mck1117/atlas/models/SelectablePullup.asc

M1: pmos; FDC638P
M2: pmos; FDC638P
M3: nmos; AP9465GEM
R1: res; 10k
R2: res; 2.7k
V1: voltage; 5
V2: voltage; 2.5
V3: voltage; 4
Named nets: 0
.dc v2 -20 20
