mck1117/atlas/models/HighPowerReverseProtection.asc

D1: zener; BZX84C6V2L
M1: pmos; HAT1072H
M2: nmos; AP9465GEM
M3: pmos; HAT1072H
R1: res; 1k
R2: res; 1
R3: res; 10k
V1: voltage; 1
V2: voltage; 5
Named nets: 0, vin, vout, vg, vs
.dc v1 -36 36
