mck1117/atlas/models/RegulatorInputFilter.asc

C1: cap; 56µ; Rser=35m
C2: cap; 56µ; Rser=35m
C3: cap; 1µ; Rser=1m
C4: cap; 4.7µ
I1: current; ""; AC 1
L1: ind; 2.2µ; Rser=1
R1: res; 1
V1: voltage; 14
Named nets: 0
.ac dec 500 100 1e8
