mck1117/atlas/models/RegulatorEnPin.asc

D1: zener; 1N750
I1: current; 5µ
R1: res; 47k
R2: res; 47k
V1: voltage; 1
Named nets: 0
.dc V1 -10 24
