mck1117/atlas/atlas/IgnInj4.kicad_sch

## KiCad design atlas/IgnInj4.kicad_sch (2022-06-28, an earlier design)

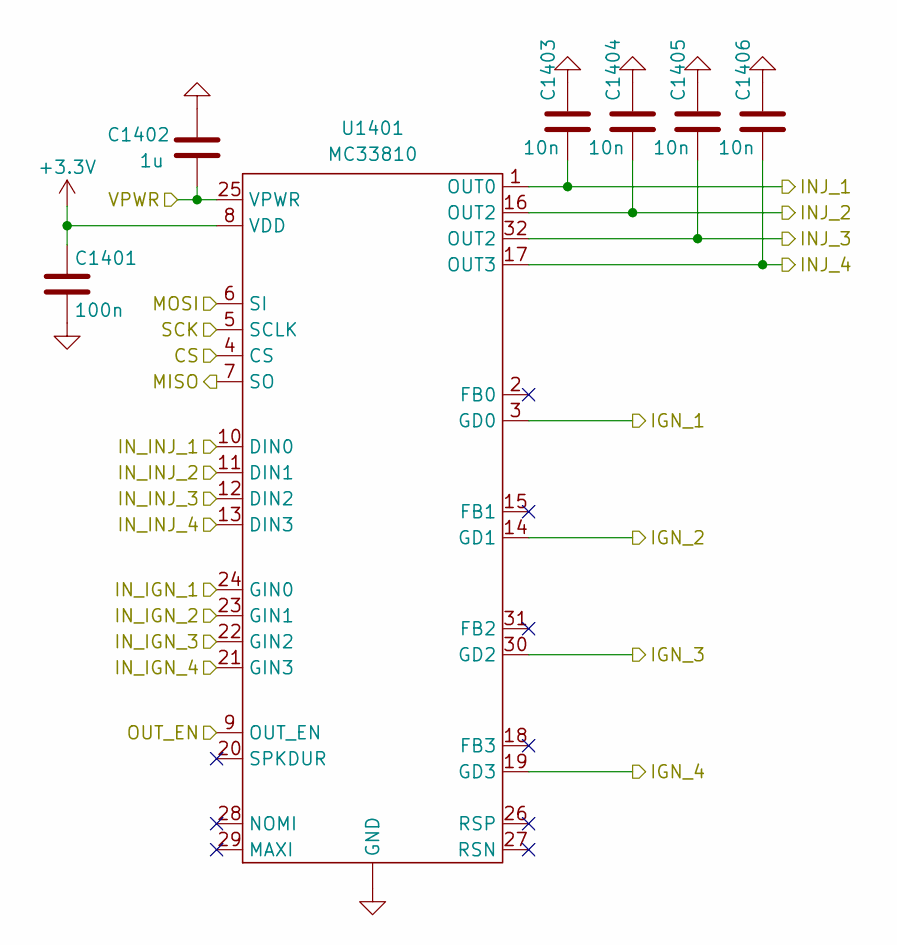
[picture p1: schematic IgnInj4.kicad_sch]

Parts:
C1401: 100n; C_0402_1005Metric
C1402: 1u; C_0603_1608Metric; LCSC C15849
C1403, C1404, C1405, C1406: 10n; C_0603_1608Metric; LCSC C57112
U1401: MC33810; SOIC-8-1EP_3.9x4.9mm_P1.27mm_EP2.29x3mm

Connections:
+3.3V: C1401.1, U1401.8 (VDD)
CS: U1401.4 (CS)
GND: C1401.2, C1402.2, C1403.1, C1404.1, C1405.1, C1406.1, U1401. (GND)
IGN_1: U1401.3 (GD0)
IGN_2: U1401.14 (GD1)
IGN_3: U1401.30 (GD2)
IGN_4: U1401.19 (GD3)
INJ_1: C1403.2, U1401.1 (OUT0)
INJ_2: C1404.2, U1401.16 (OUT2)
INJ_3: C1405.2, U1401.32 (OUT2)
INJ_4: C1406.2, U1401.17 (OUT3)
IN_IGN_1: U1401.24 (GIN0)
IN_IGN_2: U1401.23 (GIN1)
IN_IGN_3: U1401.22 (GIN2)
IN_IGN_4: U1401.21 (GIN3)
IN_INJ_1: U1401.10 (DIN0)
IN_INJ_2: U1401.11 (DIN1)
IN_INJ_3: U1401.12 (DIN2)
IN_INJ_4: U1401.13 (DIN3)
MISO: U1401.7 (SO)
MOSI: U1401.6 (SI)
OUT_EN: U1401.9 (OUT_EN)
SCK: U1401.5 (SCLK)
VPWR: C1402.1, U1401.25 (VPWR)
