mck1117/atlas/atlas/can.kicad_sch

## KiCad design atlas/can.kicad_sch (2022-06-28, an earlier design)

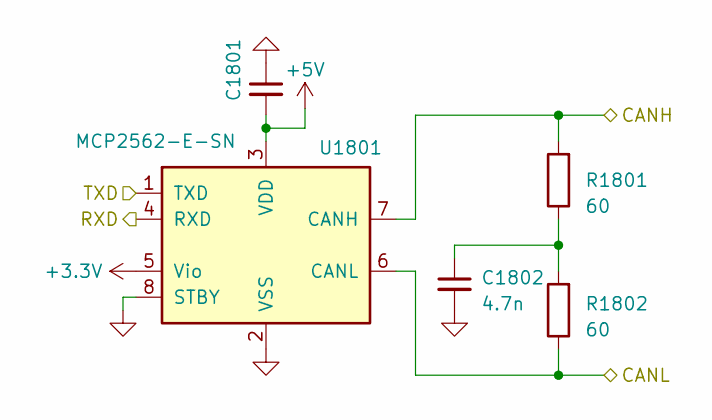
[picture p2: schematic can.kicad_sch]

Parts:
C1801: 100n; C_0402_1005Metric; LCSC C1525
C1802: 4.7n; C_0603_1608Metric
R1801, R1802: 60; R_0805_2012Metric
U1801: MCP2562-E-SN; SOIC-8_3.9x4.9mm_P1.27mm

Connections:
+3.3V: U1801.5 (Vio)
+5V: C1801.2, U1801.3 (VDD)
CANH: R1801.2, U1801.7 (CANH)
CANL: R1802.1, U1801.6 (CANL)
GND: C1801.1, C1802.2, U1801.2 (VSS), U1801.8 (STBY)
unnamed: C1802.1, R1801.1, R1802.2
RXD: U1801.4 (RXD)
TXD: U1801.1 (TXD)
