mck1117/atlas/atlas/quad_analog.kicad_sch

## KiCad design atlas/quad_analog.kicad_sch (2022-06-28, an earlier design)

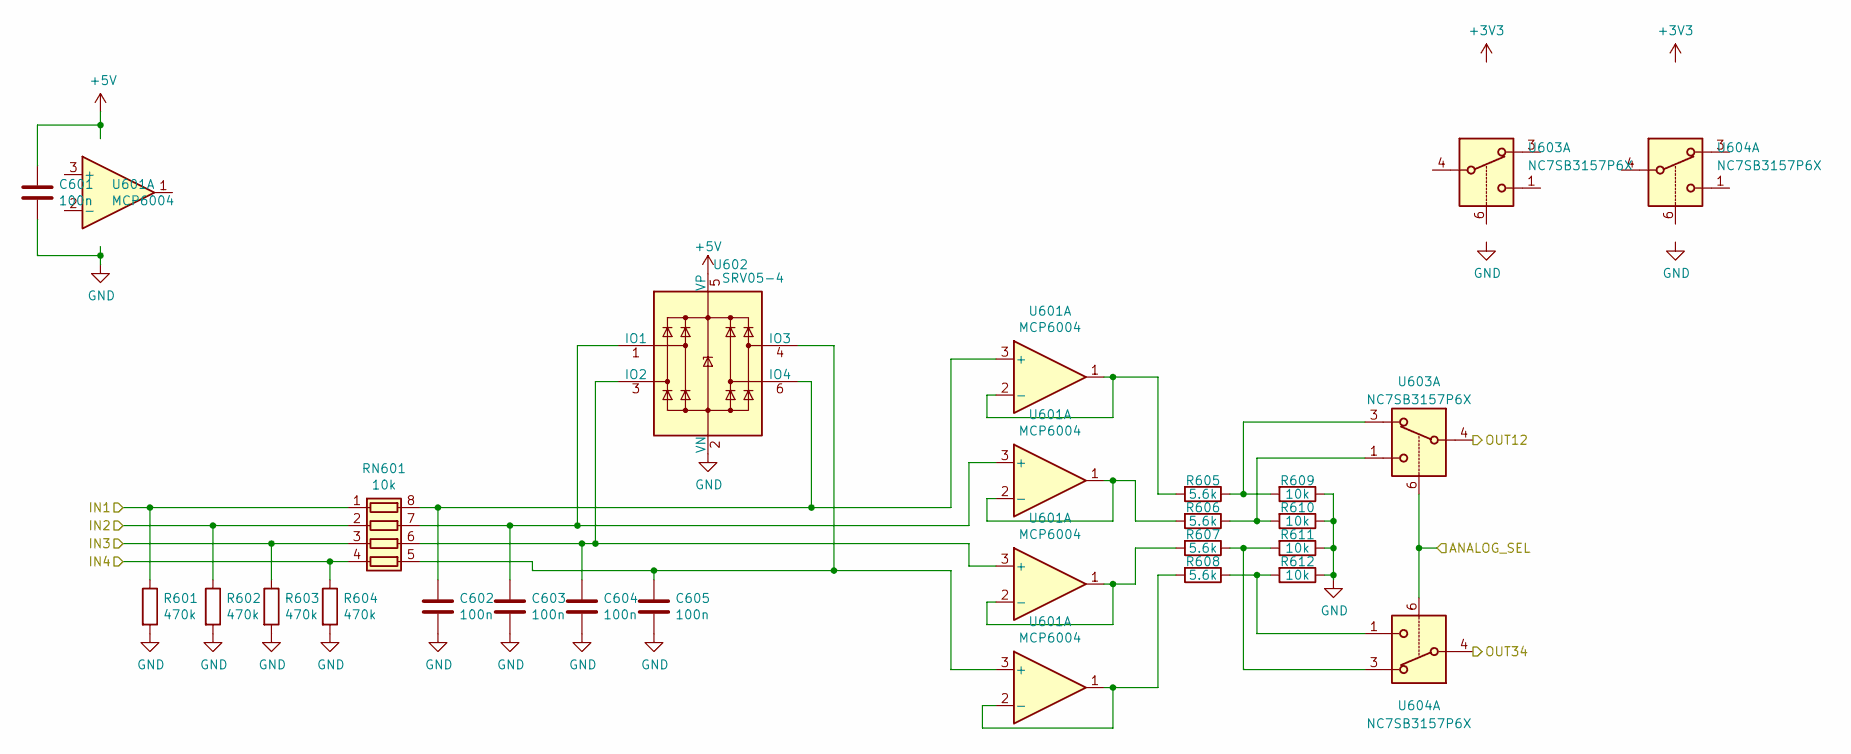
[picture p3: schematic quad_analog.kicad_sch]

Parts:
C601: 100n; C_0603_1608Metric; LCSC C14663
C602, C603, C604, C605: 100n; C_0402_1005Metric; LCSC C1525
R601, R602, R603, R604: 470k; R_0402_1005Metric; LCSC C25790
R605, R606, R607, R608: 5.6k; R_0402_1005Metric; LCSC C25908
R609, R610, R611, R612: 10k; R_0402_1005Metric; LCSC C25744
RN601: 10k; R_Array_Convex_4x0603; LCSC C29718
U601: MCP6004; TSSOP-14_4.4x5mm_P0.65mm; LCSC C7975
U602: SRV05-4; SOT-23-6; LCSC C85364
U603, U604: NC7SB3157P6X; SOT-363_SC-70-6; LCSC C87403

Connections:
+5V: C601.1, U602.5 (VP)
ANALOG_SEL: U603.6, U604.6
GND: C601.2, C602.2, C603.2, C604.2, C605.2, R601.2, R602.2, R603.2, R604.2, R609.1, R610.1, R611.1, R612.1, U602.2 (VN)
IN1: R601.1, RN601.1 (R1.1)
IN2: R602.1, RN601.2 (R2.1)
IN3: R603.1, RN601.3 (R3.1)
IN4: R604.1, RN601.4 (R4.1)
unnamed: C602.1, RN601.8 (R1.2), U601.3 (+), U602.6 (IO4)
unnamed: C603.1, RN601.7 (R2.2), U601.3 (+), U602.1 (IO1)
unnamed: C604.1, RN601.6 (R3.2), U601.3 (+), U602.3 (IO2)
unnamed: C605.1, RN601.5 (R4.2), U601.3 (+), U602.4 (IO3)
unnamed: R605.1, R609.2, U603.3
unnamed: R605.2, U601.1, U601.2 (-)
unnamed: R606.1, R610.2, U603.1
unnamed: R606.2, U601.1, U601.2 (-)
unnamed: R607.1, R611.2, U604.3
unnamed: R607.2, U601.1, U601.2 (-)
unnamed: R608.1, R612.2, U604.1
unnamed: R608.2, U601.1, U601.2 (-)
OUT12: U603.4
OUT34: U604.4
