mck1117/atlas/(threads)

Thread 10 (2021-07-18):

standby supply + battery

mck1117, 2021-07-18:
- regulator for VBAT to supply rtc and backup RAM on vehicles with constant 12v
- coin cell holder for vehicles without constant 12v

kjngineering, 2021-07-19:
Does it make sense to use a pcb mounted LIR2430 with a recharge diode from the standby rail? that way even if the battery is removed backup tables, RTC etc can be stored for some time.

mck1117, 2021-07-20:
standby regulator selected is TPS70933DBV

Thread 11 (2021-07-18):

power supply - 12v supply

mck1117, 2021-07-18:
- two pins, one for 12v raw and one for 12v ign
- diode OR together so either can power the regulator input
- 12v ign pin sets enable on regulator

mck1117, 2021-07-19:
like this:

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

mck1117, 2021-07-20:
The two resistors connected to the EN pin have changed to both 47k, this simulation says it should work ok:

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

Thread 5 (2021-07-18):

aux lowside outputs

mck1117, 2021-07-18:
How many to include?

Probably VNLD5090 or similar (or maybe single channel similar VN series chips)

kjngineering, 2021-07-19:
What are things that use aux low side:

PWM Cooling Fans
PWM A/C Compressor
PWM Water Pump
PWM/Digital Cam Phasers
PWM Oil control valve
PWM Fuel Pump (2-step, returnless)

Thread 6 (2021-07-18):

analog voltage inputs

mck1117, 2021-07-18:
12-16 channels

mck1117, 2021-07-18:
"maximum" input usage might be
- ETB TPS x4
- Pedal x2
- MAP
- compressor outlet pressure
- throttle inlet pressure
- OilP
- FuelP (x2)
- analog lambda x2

that totals ~14, so minimum viable is probably 16

kjngineering, 2021-07-19:
My experience is with motorsport but additional analog channels that I have used with regularity:

-Gearbox Compressor Pressure
-Gearbox Oil Pressure
-Gearbox Position Sensor (1x Main, 1x Tracking)
-Fuel Level
-Ambient Pressure/BAP
-Airbox Pressure
-P/Steer Pressure

Basically you can never have too many AV channels. But I also think that a CAN AV - I/O expander is also a smart idea.

kjngineering, 2021-07-19:
also consider @Dron_gus' experience using MC33972 as an analog mux for "low priority" AV polling (e.g. probably cannot exceed 10hz? with a reasonable measurement window for each sensor) - temperatures? internal diagnostic channels?

mck1117, 2021-07-19:
Another cheap option is to slap a bunch of N-to-1 analog muxes on, all switched together, so you can select one of N "banks" of analog that all get sampled in sequence.  We have plenty of time left over for more analog sampling, and it happens over DMA so the CPU load is essentially zero.

```
select_bank(0);
sample_all_adc_channels();
select_bank(1);
sample_all_adc_channels();
```

Thread 7 (2021-07-18):

analog temperature inputs

mck1117, 2021-07-18:
4-8 inputs with pullup

kjngineering, 2021-07-19:
Would it be better to leave these as AV inputs and can "switch" them to AT with a programmable pullup. Maximizes AV inputs for those who need.

Thread 8 (2021-07-18):

Onboard WBO lambda

mck1117, 2021-07-18:
2x internal wideband modules

kjngineering, 2021-07-19:
I really prefer external wideband modules that can be mounted in the engine bay and aren't tying up ecu connector IO, it also means that you can choose how many UGEO sensors required for the application.

Thread 12 (2021-07-19):

power supply - 5v & 3.3v

mck1117, 2021-07-19:
5v buck regulator
3.3v linear

TODO: which power domains should receive power from USB? Only the 3.3v domain?

Thread 13 (2021-07-19):

sensor supply

mck1117, 2021-07-19:
TLS115 seems ok, why change?

kjngineering, 2021-07-19:
Sensor supplies should have internal voltage measurement for diagnostics, can tell if a sensor is shorting the rail to ground.

ideally 3x 5v0 Sensor supplies.

mck1117, 2021-07-19:
The TLS115 at least has a "power good" output that indicates whether it's out of spec by ~70mV typical

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

kjngineering, 2021-07-19:
Some diagnostics is better than none.

mck1117, 2021-07-19:
And the PG pin is actually wired on Proteus already (but no sw for it), so we could test that with existing hardware.

Thread 14 (2021-07-19):

digital inputs

mck1117, 2021-07-19:
8? 12? digital inputs, ~2-4k pullup to 5v

kjngineering, 2021-07-19:
I really like the idea of the programmable threshold of the Universal DIG on MoTeC, what is the feasibility of this?

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

mck1117, 2021-07-19:
Programmable threshold (especially such a wide range) and hysteresis is haaaaard to do. Not cheap either.

Best I can guess, it'd need:
- DAC per channel
- digipot per channel to set hysteresis
- comparator to compare dac threshold against input signal

Not to mention an inverting boost converter to generate +-10v rails even during low voltage input (cranking, low battery and broken alternator, etc), and at least one opamp per channel to expand the range of the DAC out to +-10v.

mck1117, 2021-07-19:
The other option is what MoTeC is probably doing, which is sample at multiple mbit/s in analog, then threshold in an FPGA instead of with an analog threshold + comparator.

Thread 15 (2021-07-19):

Communication Interfaces

kjngineering, 2021-07-19:
1x USB - supports composite profile (config serial/Mass Storage - SD)
1x Universal Serial (RS232/LIN) - Could be used to receive GPS data or drive LIN devices (Alternator/Wipers)?
2x CAN2.0A
1x CANFD (5mbit-8mbit Xcvr) - now "common" in OEM
1x Ethernet (all the STM32 we are looking at now has this hardware) - is also now common in "OEM" could consider Two-Wire Ethernet. Could be good for config, file download or device comms/hacking.

mck1117, 2021-07-19:
> 1x CANFD

STM32F4/F7 can't do CANFD, only H7 (and G4)

> 1x Ethernet

It's not clear how much overhead this would incur - we don't have the luxury of a multi-core cpu or fpga, so the comms share a cpu with running the engine.

mck1117, 2021-07-19:
> Two-Wire Ethernet

a what?

kjngineering, 2021-07-19:
If there is no cost overhead then surely H7 is the logical choice? Can FD, lots of ram and flash, good peripheral set to support this sort of stuff?

H747 is also dual core so has a M4 along for the ride (if you wanted a co-processor in the same architecture we currently use) in a 208 pin LQFP.

kjngineering, 2021-07-19:
> > Two-Wire Ethernet
>
> a what?

SPE (single pair ethernet) is a newish 10Mbit standard.
https://www.pulseelectronics.com/single-twisted-pair-ethernet-automotive/

I know little about it other than I saw some automotive connector standards for it recently.

mck1117, 2021-07-19:
The cost is a wash with the H7, but there is a catch.

The way we have the ADCs configured currently:
ADC1 -> slow stuff
ADC2 -> phase-aligned sampling for the MAP sensor
ADC3 -> knock (and maybe some debug modes that are mutually exclusive with knock, like an oscilloscope for the VR sensor)

The H7 also has 3 ADCs, but ADC1 and 2 are tightly tied together, so you can't operate them independently.

Right now, that means that we get no phase-aligned MAP sampling on H7.  My V8 Volvo, the only car running on H7 that I know of, doesn't mind that too much, since it has a large intake manifold volume.  A smaller manifold or ITBs would care much much more about exactly when the MAP is sampled.

mck1117, 2021-07-19:
> The H7 also has 3 ADCs, but ADC1 and 2 are tightly tied together, so you can't operate them independently.

Some napkin math suggests we may actually be able to sample *EVERY CHANNEL* at the fast 10khz by using ADC1+ADC2 at the same time, each sampling half the channels.

kjngineering, 2022-07-05:
MCP2003 seems to implement LIN pretty easily from a UART. I've run into a few switches and lamps that are LIN controlled now.

Thread 21 (2021-09-14):

Board outline

rusefillc, 2021-09-14:
See https://github.com/rusefi/hellen154vag-9.1/issues/8

Thread 22 (2021-10-07):

case

mck1117, 2021-10-07:
dumping ground for case info/ideas/etc

mck1117, 2021-10-07:
SEALED VS UNSEALED:

- Sealed SHALL be possible
- Sealed MAY be permanent

kjngineering, 2021-10-09:
From Slack 8/10/21:

General discussion lead to agreement of the various points for the case

->130 pin count header
- Approx. min 100x150 board size (excluding connector footprint)
- Preference is for vertical headers (better choice)
- China Spec OK
- Must be sealable (glue ok)
- Base plate/Case assembly must be via fasteners (not glue)
- Must be available

Current Connector Leanings:
TE 154 Pin Header
Molex CMC/CMX 154 Pin Header (preferred)

rusefillc, 2022-01-20:
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

kjngineering, 2022-02-11:
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

Case proposal. $42USD for case, header, connector and pins in sample qty.

Larger than preferred, but seems to meet the balance of requirements.

154pin "standard" TE header, flyleads and connector kits easily available off AliExpress.
