mck1117/atlas/project/project.ioc

Mcu.UserName=STM32H743BITx
PA0.Signal=ADC1_INP16
PA1.Signal=ADC1_INP17
PA10.Signal=USART1_RX
PA11.Signal=USB_OTG_FS_DM
PA12.Signal=USB_OTG_FS_DP
PA2.Signal=ADCx_INP14
PA3.Signal=ADCx_INP15
PA4.Signal=ADCx_INP18
PA5.Signal=ADCx_INP19
PA6.Signal=ADCx_INP3
PA7.Signal=ADCx_INP7
PA9.Signal=USART1_TX
PB0.Signal=ADCx_INP9
PB1.Signal=ADCx_INP5
PB14.Signal=USB_OTG_HS_DM
PB15.Signal=USB_OTG_HS_DP
PB5.Signal=FDCAN2_RX
PB6.Signal=FDCAN2_TX
PB8.Signal=FDCAN1_RX
PB9.Signal=FDCAN1_TX
PC0.Signal=ADCx_INP10
PC1.Signal=ADCx_INP11
PC10.Signal=SDMMC1_D2
PC11.Signal=SDMMC1_D3
PC12.Signal=SDMMC1_CK
PC2_C.Signal=GPIO_Analog
PC3_C.Signal=GPIO_Analog
PC4.Signal=ADCx_INP4
PC5.Signal=ADCx_INP8
PC6.GPIO_Label=ETB PWM 2
PC6.Signal=S_TIM3_CH1
PC7.GPIO_Label=ETB PWM 1
PC7.Signal=S_TIM3_CH2
PC8.Signal=SDMMC1_D0
PC9.Signal=SDMMC1_D1
PD14.Signal=S_TIM4_CH3
PD15.Signal=S_TIM4_CH4
PD2.Signal=SDMMC1_CMD
PE11.Signal=S_TIM1_CH2
PE13.Signal=S_TIM1_CH3
PE14.Signal=S_TIM1_CH4
PE9.Signal=S_TIM1_CH1
PF10.Signal=ADC3_INP6
PF3.Signal=ADC3_INP5
PF4.Signal=ADC3_INP9
PF5.Signal=ADC3_INP4
PF6.Signal=ADC3_INP8
PF7.Signal=ADC3_INP3
PF8.Signal=ADC3_INP7
PF9.Signal=ADC3_INP2
PH2.Signal=ADC3_INP13
PH3.Signal=ADC3_INP14
PH4.Signal=ADC3_INP15
PH5.Signal=ADC3_INP16
PI2.Signal=S_TIM8_CH4
PJ6.Signal=S_TIM8_CH2
PJ8.Signal=S_TIM8_CH1
PK0.Signal=S_TIM8_CH3
