mck1117/atlas/(commit log)

2021-07-18 blank project + ignore
    [atlas.kicad_pcb, atlas.kicad_sch]
2021-07-18 update ignore for kicad6
2021-07-18 5v psu part
    [atlas.kicad_sch, psu.kicad_sch]
2021-07-19 sensor supply
    [atlas.kicad_sch, psu.kicad_sch]
2021-07-20 assign some components
    [atlas.kicad_sch, psu.kicad_sch]
2021-07-20 add EN pin model
2021-07-20 input filter
2021-07-20 bigger load dump diodes
    [atlas.kicad_sch, psu.kicad_sch]
2021-07-20 filter esr
2021-07-21 analog pullups
    [atlas.kicad_sch, quad_analog_pullup.kicad_sch]
2021-07-21 pin mapping
    [atlas.kicad_sch, mcu.kicad_sch, quad_analog.kicad_sch, quad_analog_pullup.kicad_sch]
2021-07-26 hellen modules
    [atlas.kicad_sch, mcu.kicad_sch, psu.kicad_sch, quad_analog.kicad_sch, quad_analog_pullup.kicad_sch]
2021-07-26 footprints & lcsc
    [IgnInj4.kicad_sch, atlas.kicad_sch, can.kicad_sch, mcu.kicad_sch, psu.kicad_sch, quad_analog.kicad_sch]
2022-06-28 upgrade kicad
    [IgnInj4.kicad_sch, atlas.kicad_sch, can.kicad_sch, digital_in.kicad_sch, mcu.kicad_sch, psu.kicad_sch, quad_analog.kicad_sch, quad_analog_pullup.kicad_sch]
